interactionresearchstudio/VisionCam_Selfie_Hooked_Case/Pi Cam Back.step

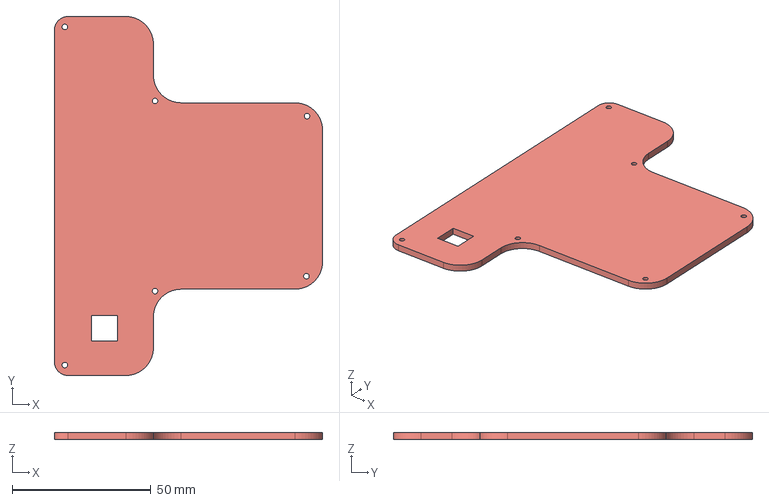
[picture p3: CAD file, 2017-12-20]
Pi Cam Back.step
96.9 x 129.6 x 2.50 mm
