interactionresearchstudio/VisionCam_Selfie_Hooked_Case/(list of files, cad)

Other CAD files:
Back.dwg
Pi Cam Back.stl
